itrussell15/SplitFlapDisplay/PCBs/driver-v3/board_schematic.png

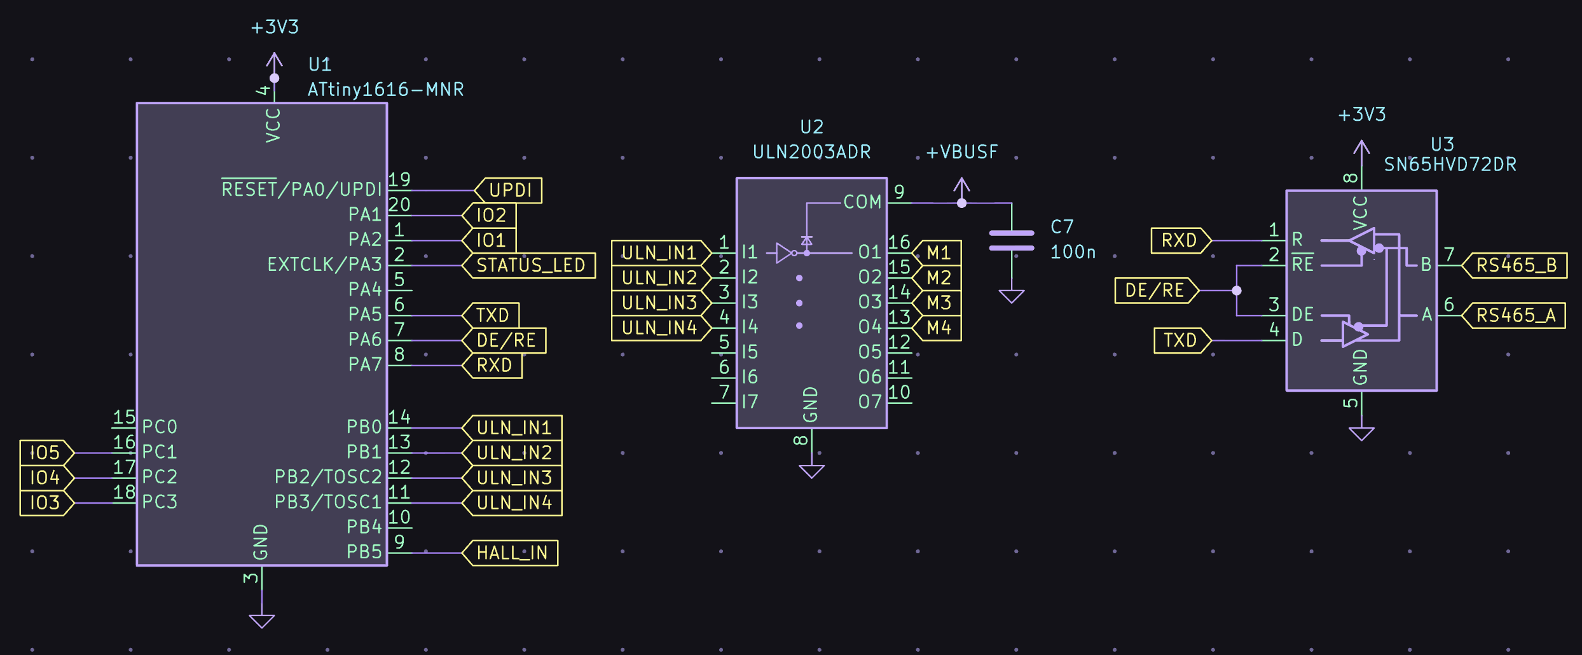
PCBs/driver-v3/board_schematic.png
