itrussell15/SplitFlapDisplay/PCBs/driver-v3/FAB/BOM File.xls

Comment | Designator | Footprint | JLCPCB Part #
ATtiny1616-MNR | U1 | VQFN-20-1EP_3x3mm_P0.4mm_EP1.7x1.7mm | C507118
470n | C3,C8,C6,C2 | C_0603_1608Metric | C1623
ULN2003ADR | U2 | SOIC-16W_5.3x10.2mm_P1.27mm | C7512
HallEffect | J4 | PinHeader_1x03_P2.54mm_Vertical | C131339
100u | C1 | C_Elec_5x5.4 | C3347
100n | C7 | C_0603_1608Metric | C14663
0R | R1 | R_0805_2012Metric | C17477
LED | D1 | LED_0201_0603Metric | C2286
StepperConnector | J3 | JST_XH_B5B-XH-A_1x05_P2.50mm_Vertical | C157991
SN65HVD72DR | U3 | SOIC-8_5.3x6.2mm_P1.27mm | C48125
60R | R2 | R_0201_0603Metric | C166918
SPX3819M5-L-3-3 | U5 | SOT-23-5 | C20617301
SPX3819M5-L-5-0 | U6 | SOT-23-5 | C20617302
10u | C5,C9,C4 | C_0603_1608Metric | C19702
