itrussell15/SplitFlapDisplay/CAD Files/Drum_Main.3mf

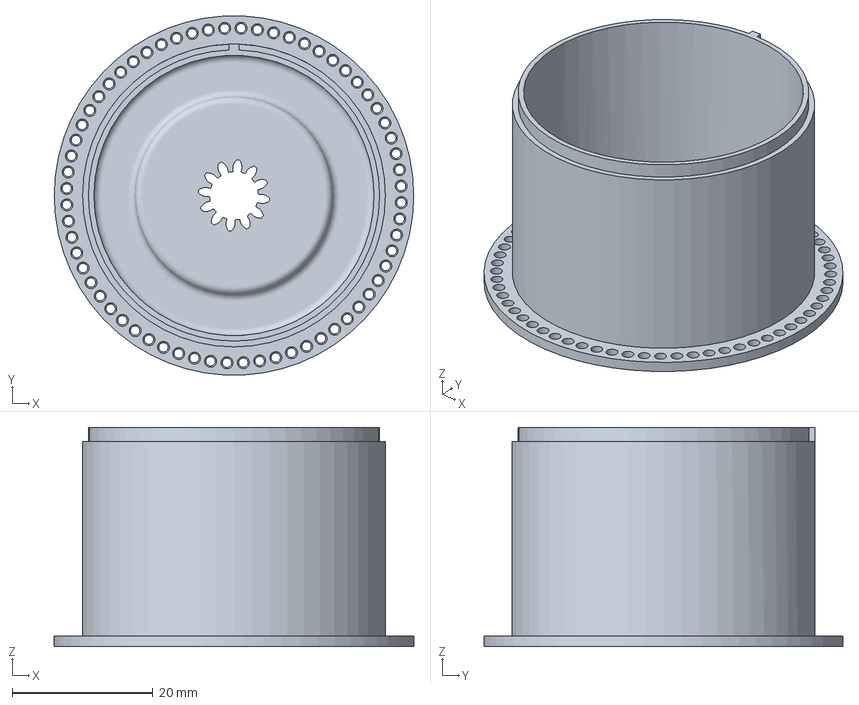
[picture p6: CAD file, 2026-07-28]
CAD Files/Drum_Main.3mf
51.0 x 50.9 x 31.1 mm
