itrussell15/SplitFlapDisplay/CAD Files/Character Drum - Character Drum Main.3mf

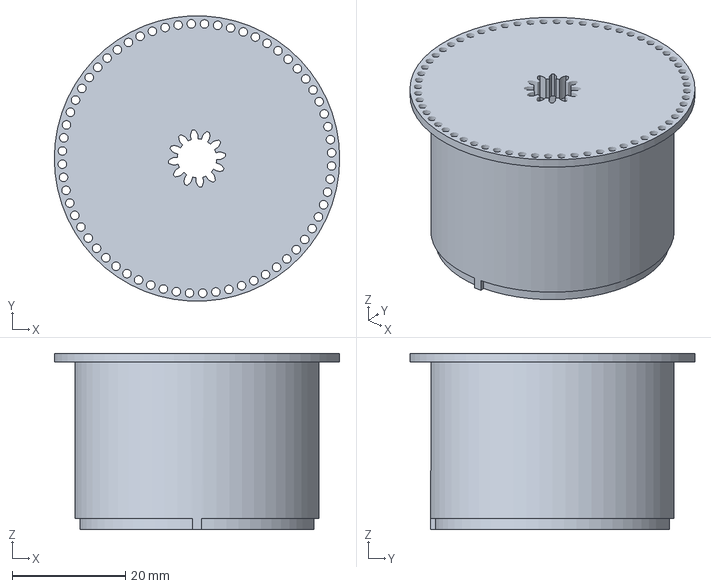
[picture p7: CAD file, 2026-05-07]
CAD Files/Character Drum - Character Drum Main.3mf
50.3 x 50.2 x 31.1 mm
