itrussell15/SplitFlapDisplay/CAD Files/64FlapsWithLetters (parts and bambu print profile)/Flap7.3mf

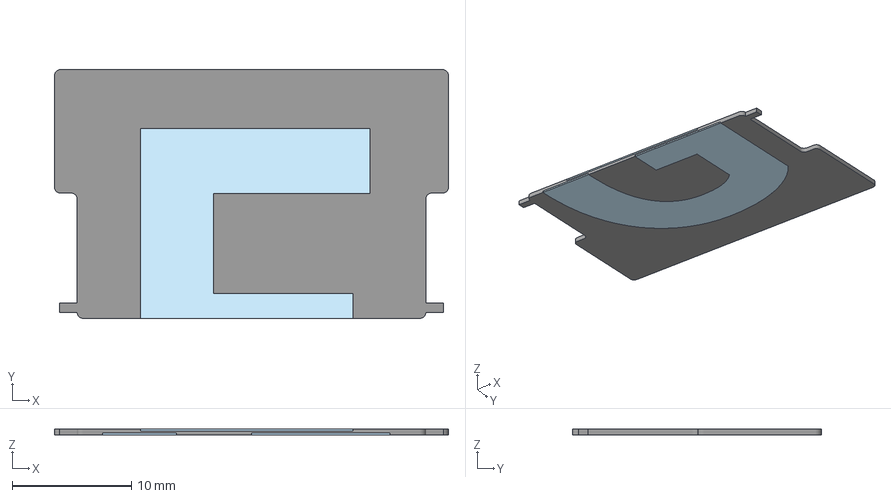
[picture p8: CAD file, 2026-05-07]
CAD Files/64FlapsWithLetters (parts and bambu print profile)/Flap7.3mf
33.1 x 20.9 x 0.48 mm
G_Bottom
Flap7
F_Top
