itrussell15/SplitFlapDisplay/CAD Files/flaps/mini_plate.3mf

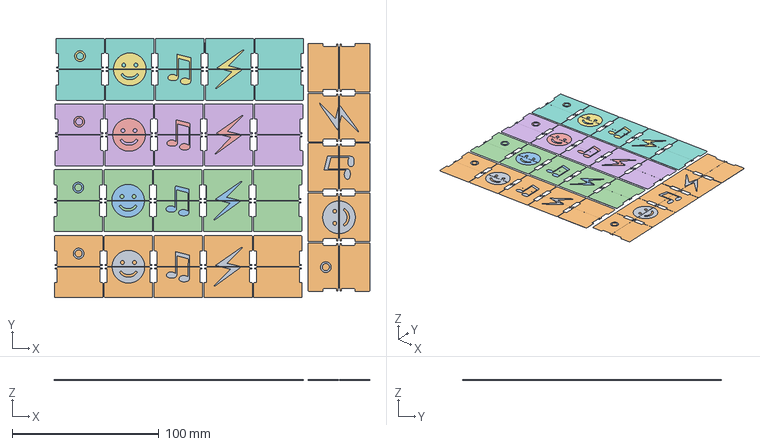
[picture p9: CAD file, 2026-08-07]
CAD Files/flaps/mini_plate.3mf
215.6 x 177.0 x 0.48 mm
mini_plate-inlay.stl x 5
mini_plate.stl x 5
