itrussell15/SplitFlapDisplay/CAD Files/flaps/single/3-E.3mf

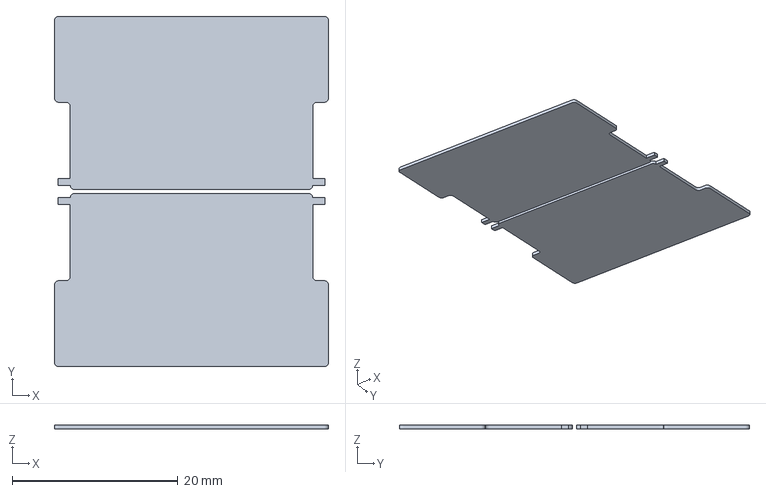
[picture p10: CAD file, 2026-09-01]
CAD Files/flaps/single/3-E.3mf
33.1 x 42.3 x 0.48 mm
