itrussell15/SplitFlapDisplay/flaps-generator/examples/1-flaps.stl

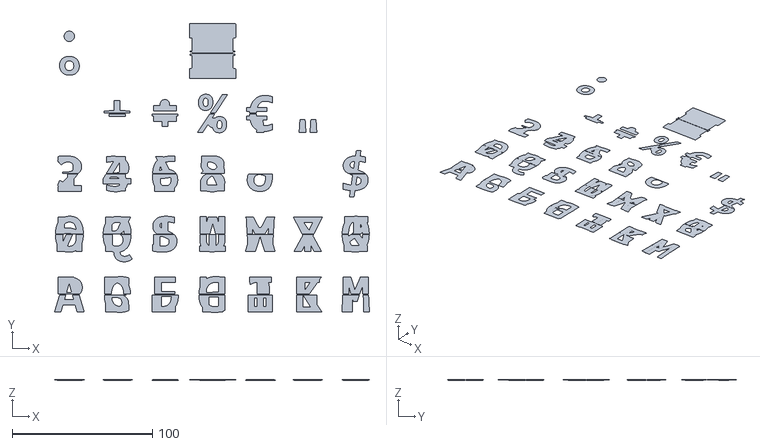
[picture p12: CAD file, 2026-05-22]
flaps-generator/examples/1-flaps.stl
224.4 x 206.0 x 0.48
