itrussell15/SplitFlapDisplay/flaps-generator/generated/Flaps_holding_case.stl

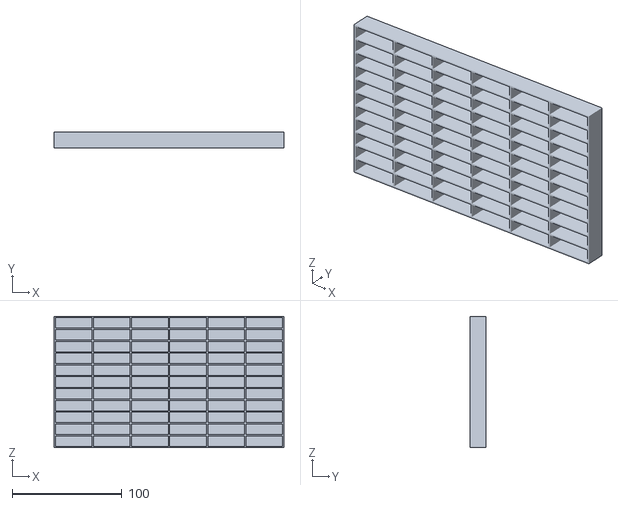
[picture p13: CAD file, 2026-06-04]
flaps-generator/generated/Flaps_holding_case.stl
210.0 x 15.0 x 120.0
