itrussell15/SplitFlapDisplay/flaps-generator/generated/plate1/plate1_inlay.stl

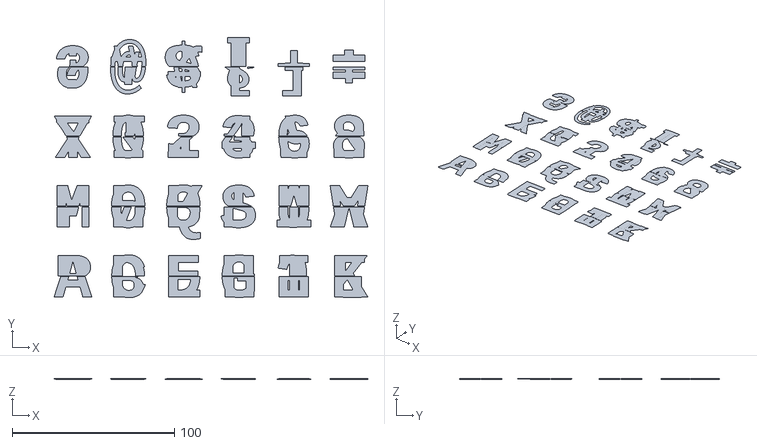
[picture p14: CAD file, 2026-06-03]
flaps-generator/generated/plate1/plate1_inlay.stl
193.3 x 160.3 x 0.48
