itrussell15/SplitFlapDisplay/flaps-generator/generated/plate2/plate2_inlay.stl

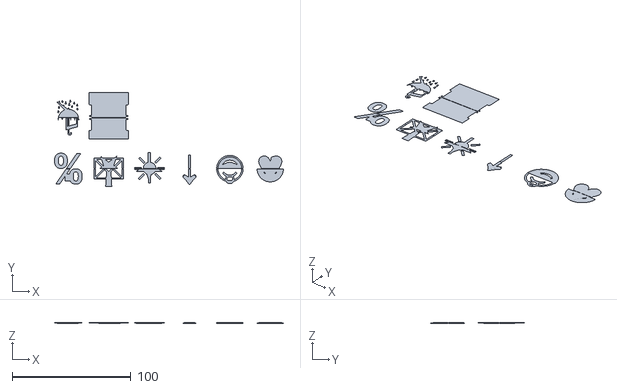
[picture p15: CAD file, 2026-06-03]
flaps-generator/generated/plate2/plate2_inlay.stl
192.8 x 79.2 x 0.48
