itrussell15/SplitFlapDisplay/flaps-generator/generated/plate3/plate3_inlay.stl

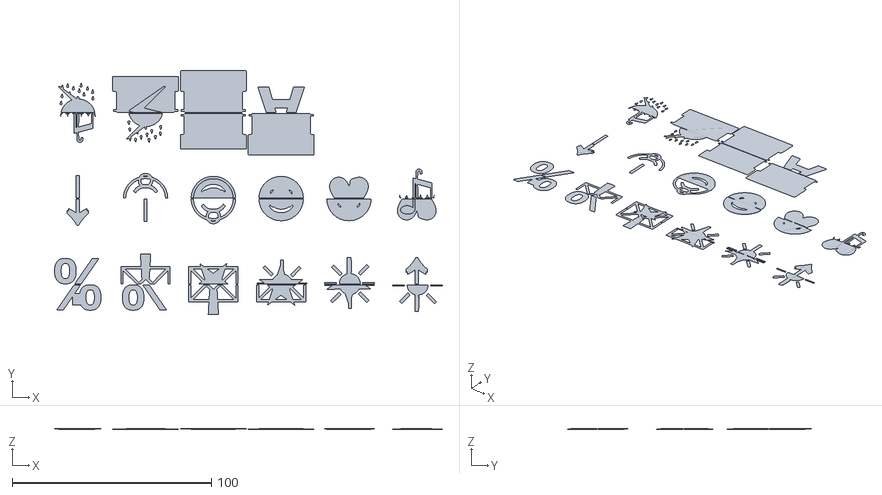
[picture p16: CAD file, 2026-06-02]
flaps-generator/generated/plate3/plate3_inlay.stl
194.6 x 122.2 x 0.48
