itrussell15/SplitFlapDisplay/PCBs/bus-board/SplitFlapBusBoard.step

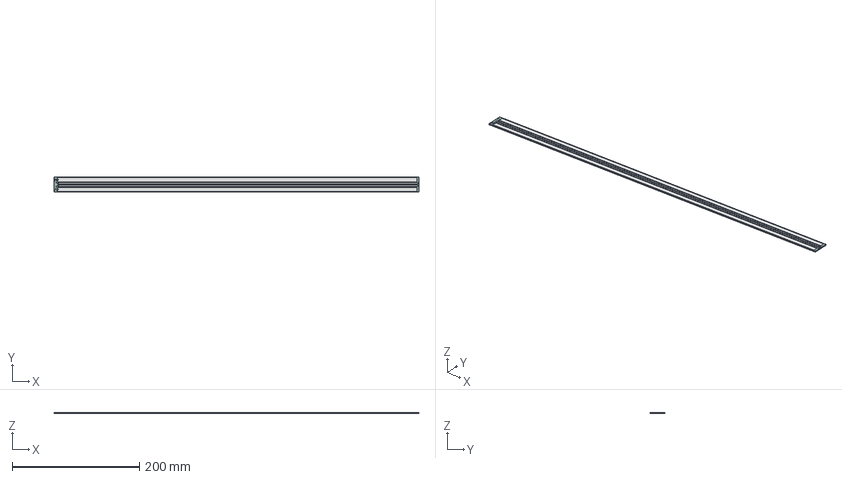
[picture p17: CAD file, 2026-05-07]
PCBs/bus-board/SplitFlapBusBoard.step
572.6 x 24.0 x 1.62 mm
SplitFlapBusBoard_pad
SplitFlapBusBoard_silkscreen
SplitFlapBusBoard_PCB
