itrussell15/SplitFlapDisplay/CAD Files/64FlapsWithLetters (parts and bambu print profile)/Flap31.3mf

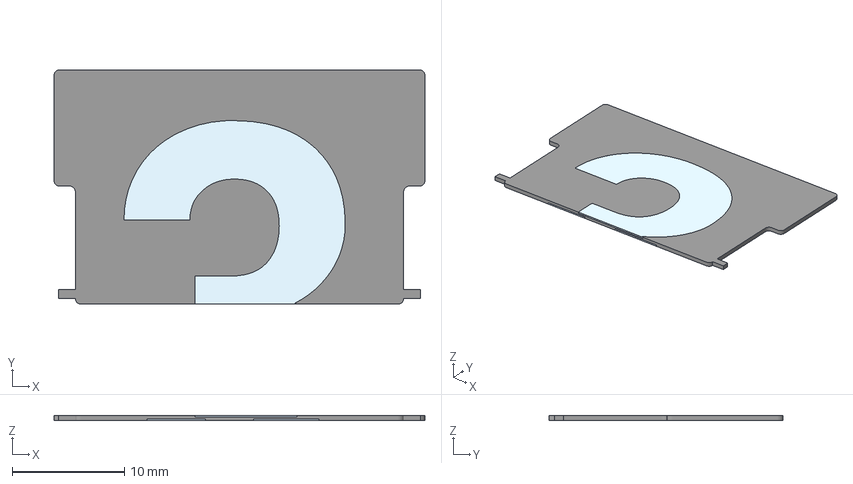
[picture p18: CAD file, 2026-05-07]
CAD Files/64FlapsWithLetters (parts and bambu print profile)/Flap31.3mf
33.1 x 20.9 x 0.48 mm
4_Bottom
Flap31
3_Top
