itrussell15/SplitFlapDisplay/CAD Files/Drum_Lip.3mf

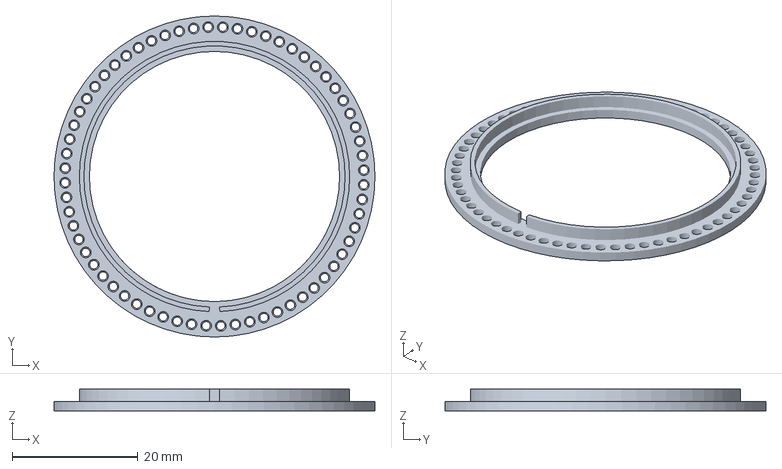
[picture p19: CAD file, 2026-07-28]
CAD Files/Drum_Lip.3mf
51.0 x 51.0 x 3.45 mm
