itrussell15/SplitFlapDisplay/CAD Files/flaps/mega_plate.3mf

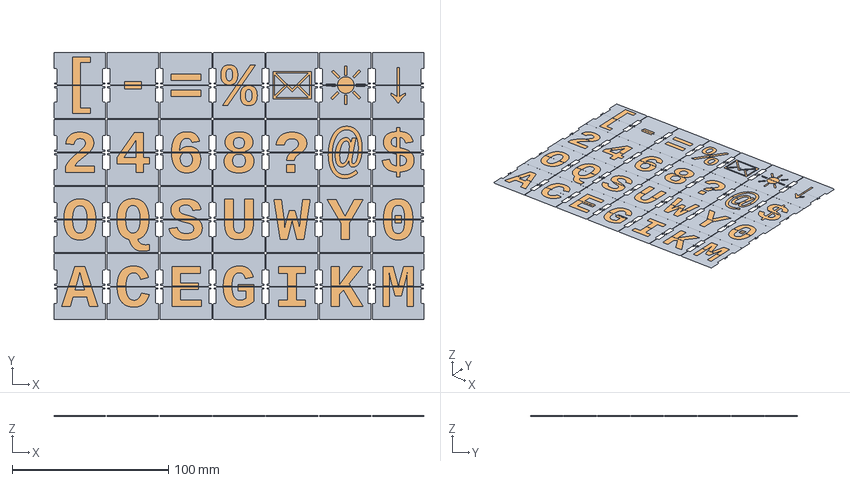
[picture p20: CAD file, 2026-08-07]
CAD Files/flaps/mega_plate.3mf
237.1 x 171.3 x 0.48 mm
mega_plate2.stl
mega_plate2-inlay.stl
