itrussell15/SplitFlapDisplay/CAD Files/flaps/single/2-C.3mf

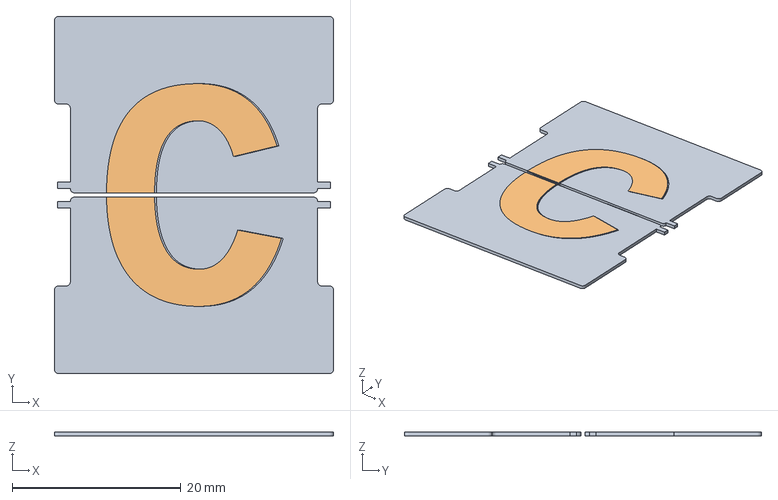
[picture p21: CAD file, 2026-09-01]
CAD Files/flaps/single/2-C.3mf
33.1 x 42.3 x 0.48 mm
2-C.stl
2-C-inlay.stl
