itrussell15/SplitFlapDisplay/CAD Files/flaps/small_plate2.3mf

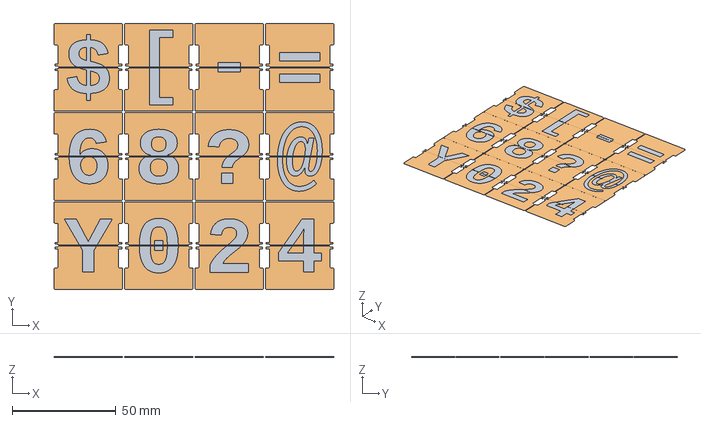
[picture p23: CAD file, 2026-07-28]
CAD Files/flaps/small_plate2.3mf
135.1 x 128.3 x 0.48 mm
small_plate2_inlay.stl
small_plate2.stl
