itrussell15/SplitFlapDisplay/CAD Files/top_cover.3mf

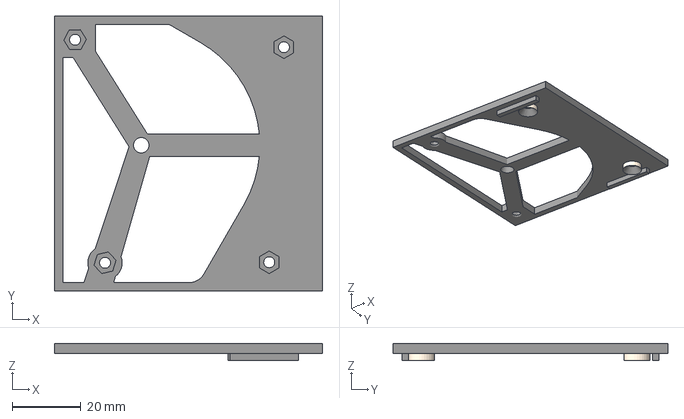
[picture p24: CAD file, 2026-07-22]
CAD Files/top_cover.3mf
78.0 x 80.0 x 5.00 mm
