itrussell15/SplitFlapDisplay/flaps-generator/examples/4-flaps.stl

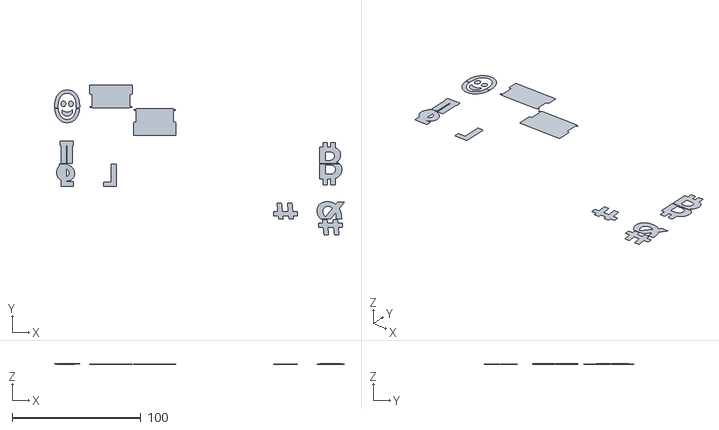
[picture p25: CAD file, 2026-05-22]
flaps-generator/examples/4-flaps.stl
225.1 x 116.6 x 0.48
