itrussell15/SplitFlapDisplay/flaps-generator/flap.dxf

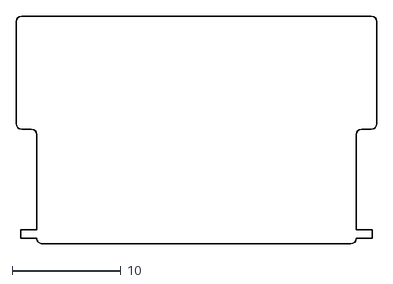
[picture p26: CAD file, 2026-05-07]
flaps-generator/flap.dxf
33.1 x 20.9
