itrussell15/SplitFlapDisplay/CAD Files/flaps/small_plate3.3mf

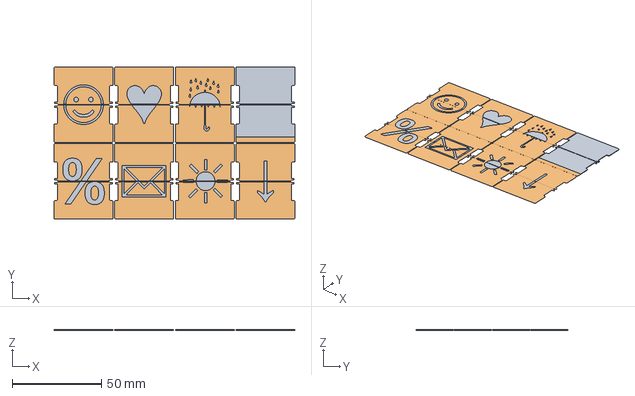
[picture p29: CAD file, 2026-07-18]
CAD Files/flaps/small_plate3.3mf
135.2 x 85.4 x 0.48 mm
small_plate3_inlay.stl
small_plate3.stl
