itrussell15/SplitFlapDisplay/flaps-generator/examples/0-flaps.stl

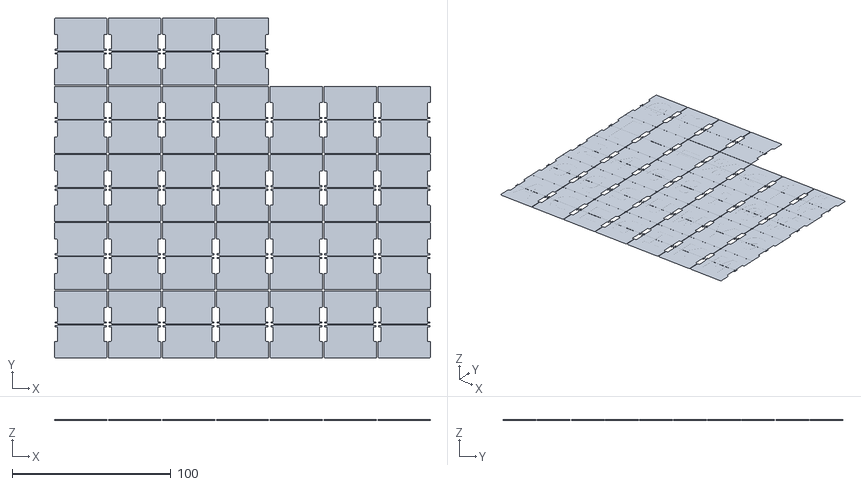
[picture p30: CAD file, 2026-05-22]
flaps-generator/examples/0-flaps.stl
237.1 x 214.3 x 0.48
