itrussell15/SplitFlapDisplay/CAD Files/flaps/small_plate1.3mf

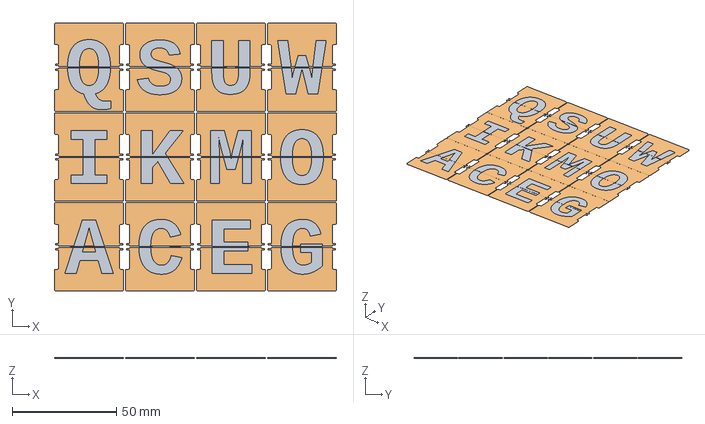
[picture p32: CAD file, 2026-07-18]
CAD Files/flaps/small_plate1.3mf
135.1 x 128.3 x 0.48 mm
small_plate1_inlay.stl
small_plate1.stl
