itrussell15/SplitFlapDisplay/CAD Files/Gear_Plate.3mf

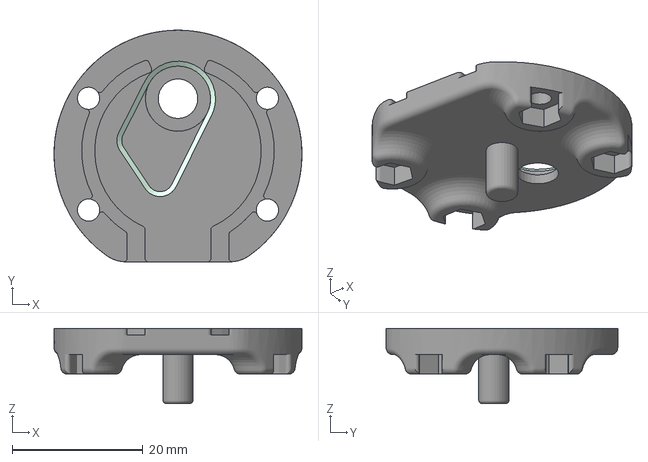
[picture p33: CAD file, 2026-07-15]
CAD Files/Gear_Plate.3mf
38.0 x 35.5 x 11.5 mm
