itrussell15/SplitFlapDisplay/flaps-generator/examples/3-flaps.stl

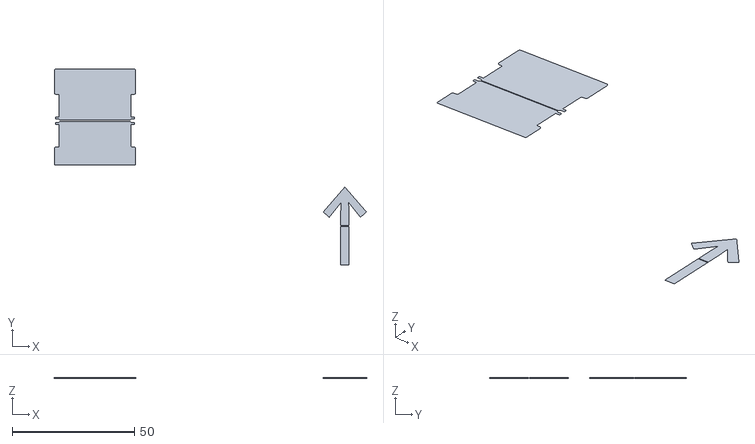
[picture p34: CAD file, 2026-05-22]
flaps-generator/examples/3-flaps.stl
127.4 x 80.1 x 0.16
