itrussell15/SplitFlapDisplay/CAD Files/flaps/plate1.3mf

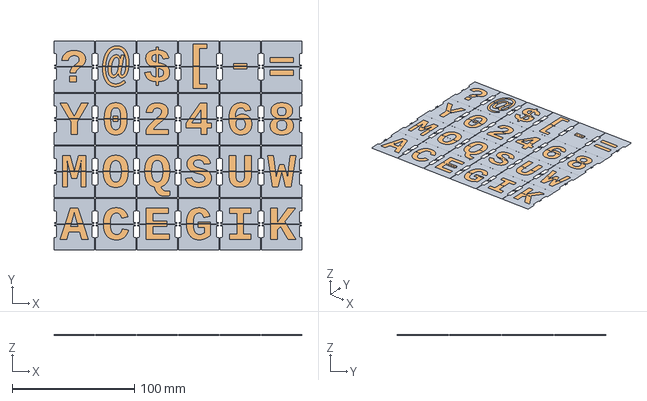
[picture p35: CAD file, 2026-07-03]
CAD Files/flaps/plate1.3mf
203.1 x 171.3 x 0.48 mm
plate1.stl
plate1_inlay.stl
