itrussell15/SplitFlapDisplay/CAD Files/module_case.3mf

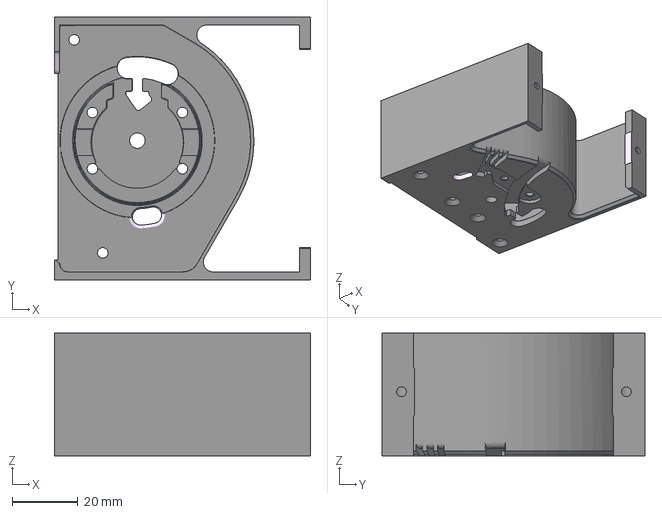
[picture p37: CAD file, 2026-07-10]
CAD Files/module_case.3mf
78.0 x 80.0 x 37.4 mm
