itrussell15/SplitFlapDisplay/CAD Files/Din Bracket EasierV2.stl

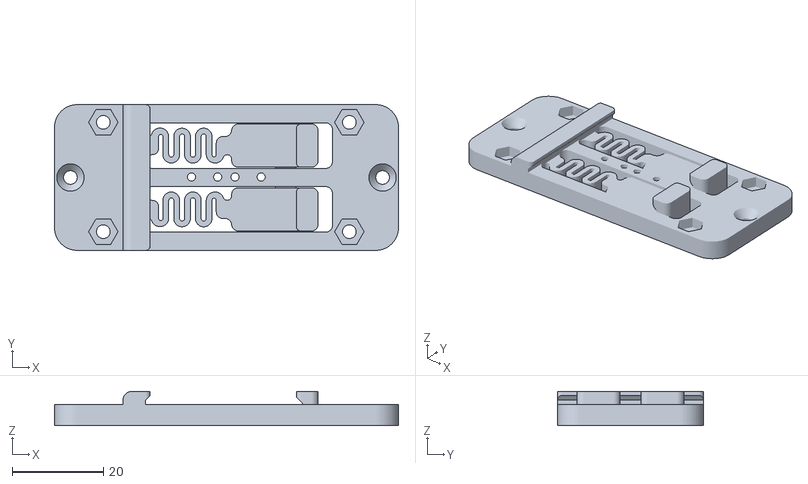
[picture p38: CAD file, 2026-05-11]
CAD Files/Din Bracket EasierV2.stl
75.5 x 32.0 x 7.50
