itrussell15/SplitFlapDisplay/CAD Files/flaps/plate2.3mf

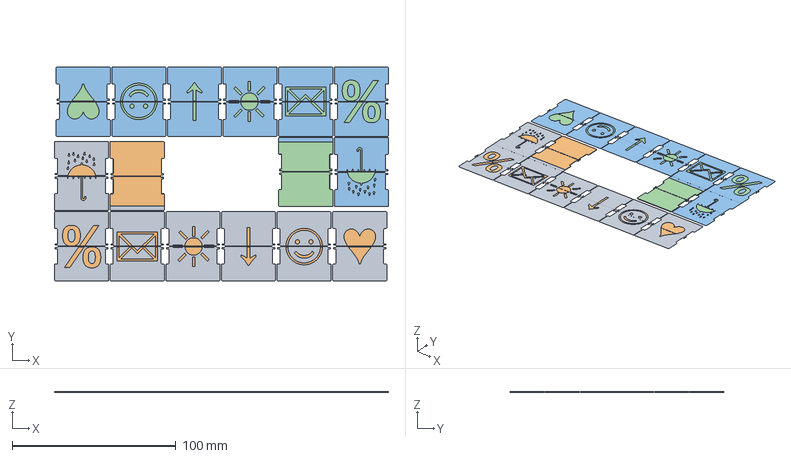
[picture p39: CAD file, 2026-06-04]
CAD Files/flaps/plate2.3mf
204.1 x 130.7 x 0.48 mm
plate2.stl x 2
plate2_inlay.stl x 2
