itrussell15/SplitFlapDisplay/flaps-generator/examples/2-flaps.stl

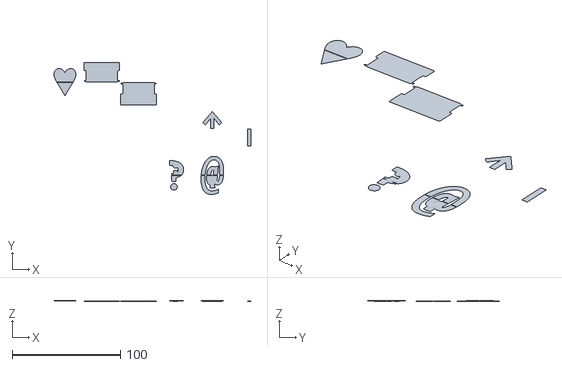
[picture p41: CAD file, 2026-05-22]
flaps-generator/examples/2-flaps.stl
181.8 x 121.8 x 0.48
