itrussell15/SplitFlapDisplay/CAD Files/Module Enclosure - Enclosure Cover Bottom.3mf

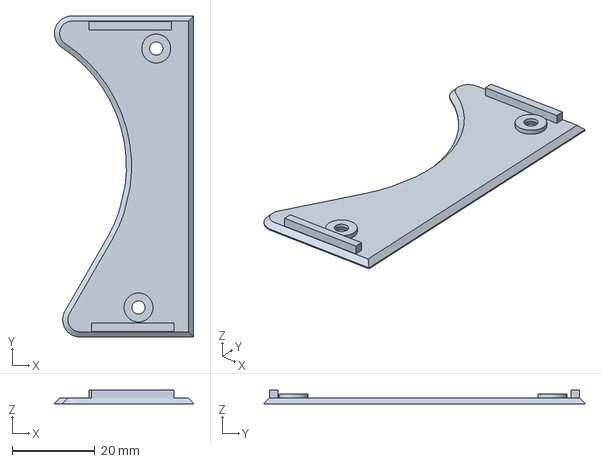
[picture p42: CAD file, 2026-05-07]
CAD Files/Module Enclosure - Enclosure Cover Bottom.3mf
33.6 x 77.6 x 3.50 mm
