itrussell15/SplitFlapDisplay/CAD Files/Wire Retainer.3mf

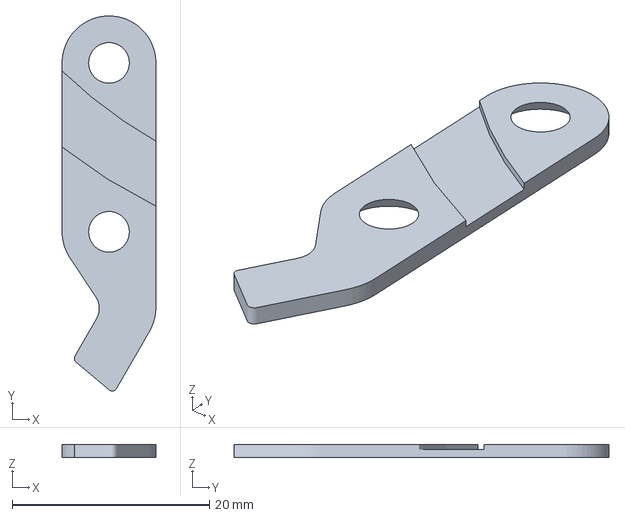
[picture p45: CAD file, 2026-05-07]
CAD Files/Wire Retainer.3mf
9.52 x 38.0 x 1.30 mm
