itrussell15/SplitFlapDisplay/CAD Files/Motor Gear.3mf

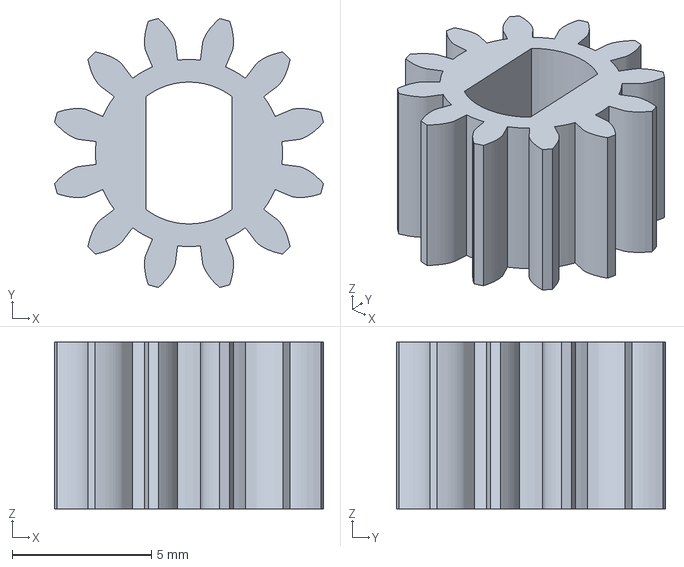
[picture p46: CAD file, 2026-05-07]
CAD Files/Motor Gear.3mf
9.67 x 9.67 x 6.00 mm
