itrussell15/SplitFlapDisplay/CAD Files/64FlapsWithLetters (parts and bambu print profile)/64FlapsPrintProfile.3mf

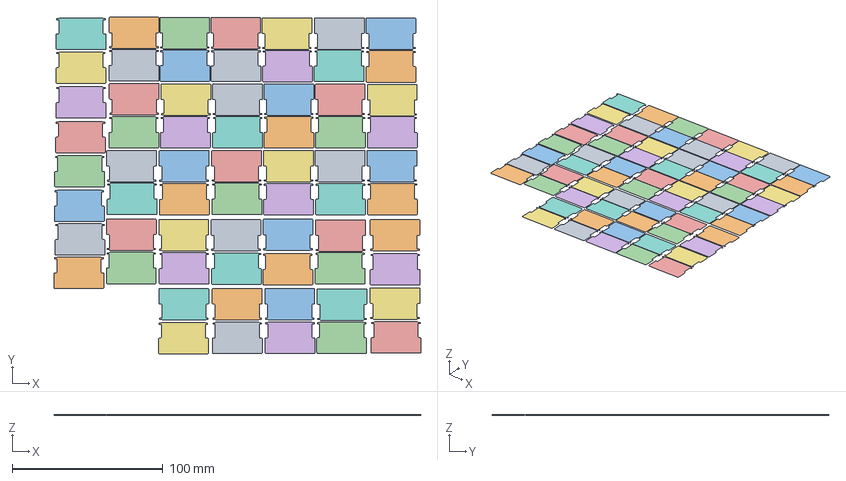
[picture p47: CAD file, 2026-05-07]
CAD Files/64FlapsWithLetters (parts and bambu print profile)/64FlapsPrintProfile.3mf
243.4 x 223.3 x 0.48 mm
Flap10
Flap2
Flap3
Flap4
Flap6
Flap7
Flap8
Flap9
Flap1
Flap11
Flap12
Flap13
Flap14
Flap15
Flap16
Flap17
Flap18
Flap19
Flap20
Flap21
Flap22
Flap23
Flap24
Flap25
Flap26
Flap27
Flap28
Flap29
Flap30
Flap31
Flap32
Flap33
Flap34
Flap35
Flap36
Flap37
Flap38
Flap39
Flap40
Flap41
Flap42
Flap43
Flap44
Flap45
Flap46
Flap47
Flap49
Flap50
Flap51
Flap52
Flap54
Flap55
Flap57 x 9
Flap53
Flap58
Assembly
Flap5
Flap48
