itrussell15/SplitFlapDisplay/CAD Files/Center Gear.3mf

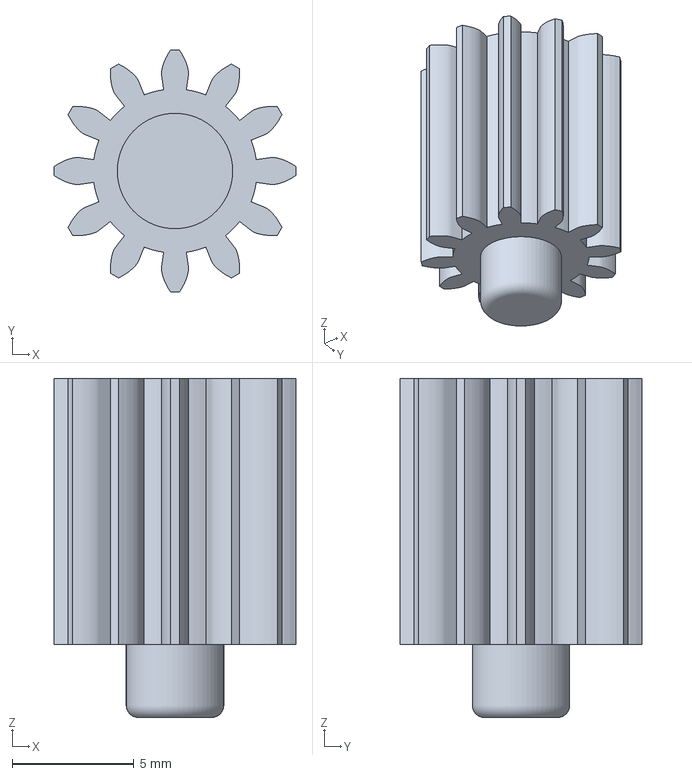
[picture p48: CAD file, 2026-05-07]
CAD Files/Center Gear.3mf
9.91 x 9.91 x 13.9 mm
