itrussell15/SplitFlapDisplay/CAD Files/flaps/single/32-WHITE.3mf

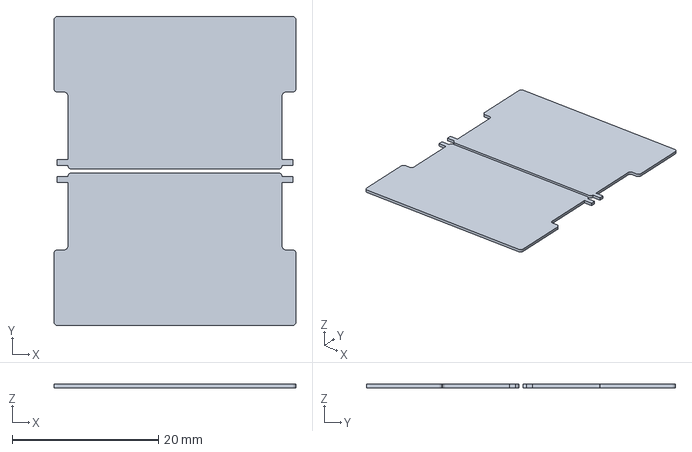
[picture p49: CAD file, 2026-08-17]
CAD Files/flaps/single/32-WHITE.3mf
33.1 x 42.3 x 0.48 mm
