itrussell15/SplitFlapDisplay/CAD Files/64FlapsWithLetters (parts and bambu print profile)/Flap57 - Blank (print 7).3mf

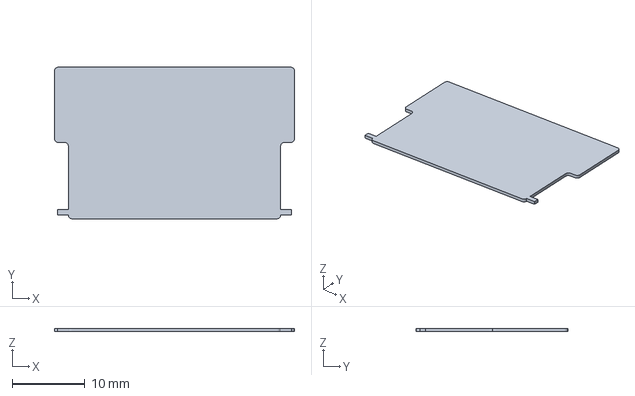
[picture p50: CAD file, 2026-05-07]
CAD Files/64FlapsWithLetters (parts and bambu print profile)/Flap57 - Blank (print 7).3mf
33.1 x 20.9 x 0.48 mm
