itrussell15/SplitFlapDisplay/CAD Files/64FlapsWithLetters (parts and bambu print profile)/Flap56.3mf

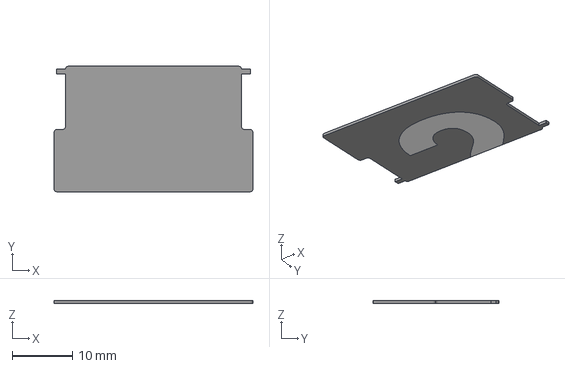
[picture p51: CAD file, 2026-05-07]
CAD Files/64FlapsWithLetters (parts and bambu print profile)/Flap56.3mf
33.1 x 20.9 x 0.48 mm
Question_Top
Flap56
