itrussell15/SplitFlapDisplay/CAD Files/Character Drum - Character Drum Lip.3mf

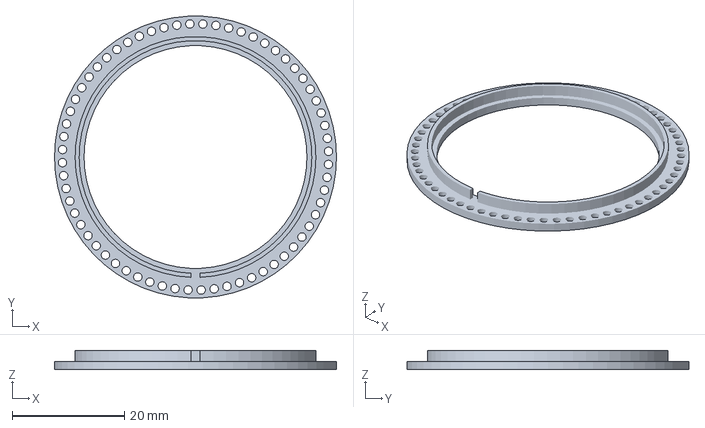
[picture p53: CAD file, 2026-05-07]
CAD Files/Character Drum - Character Drum Lip.3mf
50.3 x 50.2 x 3.45 mm
