itrussell15/SplitFlapDisplay/CAD Files/Character Drum.3mf

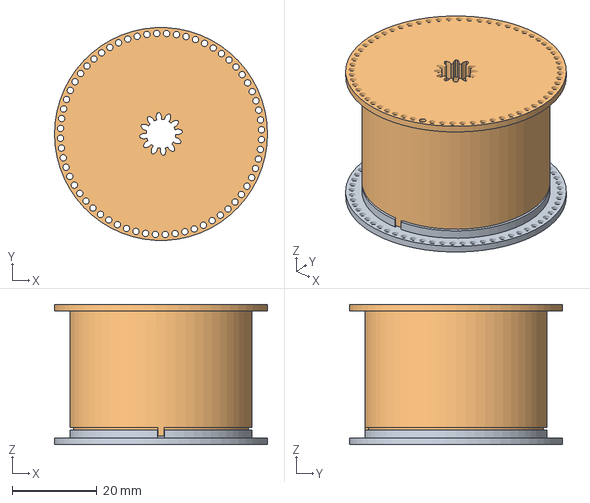
[picture p55: CAD file, 2026-05-07]
CAD Files/Character Drum.3mf
50.3 x 50.2 x 33.1 mm
Character Drum Lip
Character Drum Main
