itrussell15/SplitFlapDisplay/CAD Files/Module Enclosure - Enclosure Cover Top.3mf

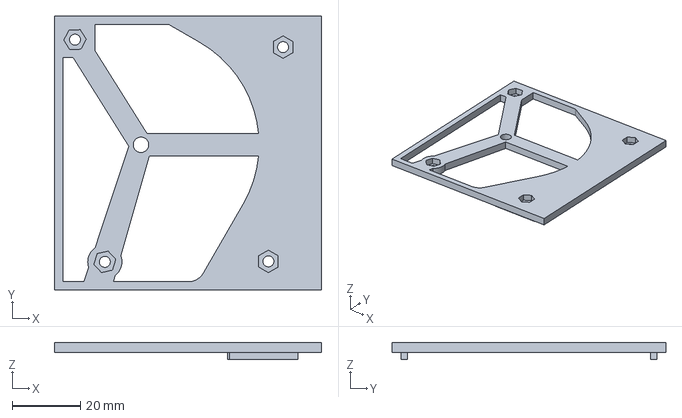
[picture p56: CAD file, 2026-05-07]
CAD Files/Module Enclosure - Enclosure Cover Top.3mf
78.0 x 80.0 x 5.00 mm
