itrussell15/SplitFlapDisplay/CAD Files/64FlapsWithLetters (parts and bambu print profile)/Flap39.3mf

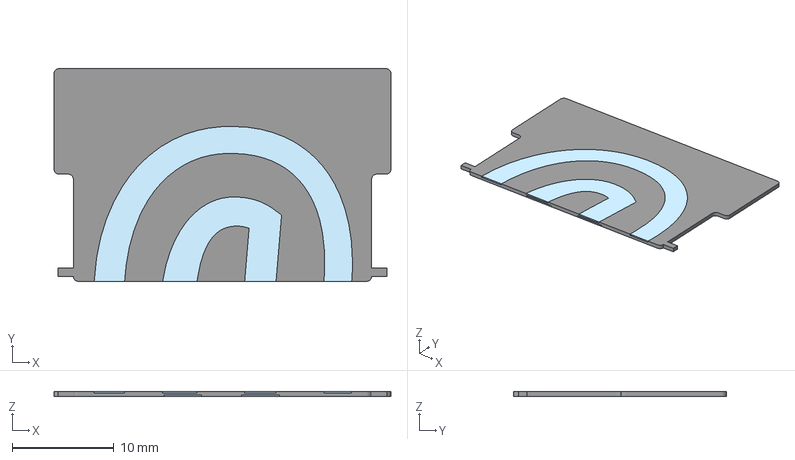
[picture p58: CAD file, 2026-05-07]
CAD Files/64FlapsWithLetters (parts and bambu print profile)/Flap39.3mf
33.1 x 20.9 x 0.48 mm
AT_Top x 2
Pound_Bottom
Flap39
