itrussell15/SplitFlapDisplay/CAD Files/flaps/single/28-DOWN.3mf

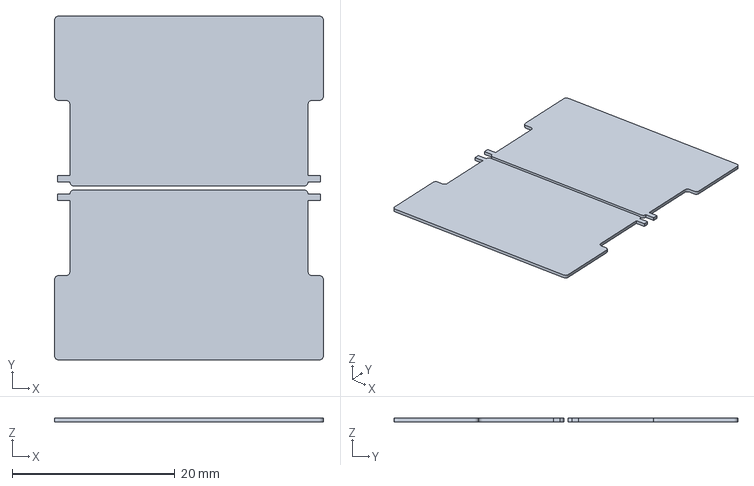
[picture p61: CAD file, 2026-08-17]
CAD Files/flaps/single/28-DOWN.3mf
33.1 x 42.3 x 0.48 mm
