itrussell15/SplitFlapDisplay/CAD Files/64FlapsWithLetters (parts and bambu print profile)/Flap46.3mf

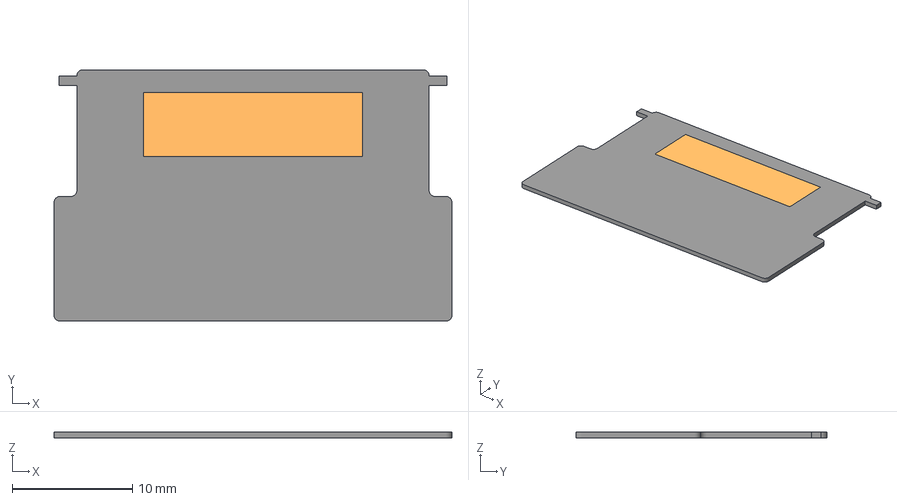
[picture p62: CAD file, 2026-05-07]
CAD Files/64FlapsWithLetters (parts and bambu print profile)/Flap46.3mf
33.1 x 20.9 x 0.48 mm
Flap46
Equal_Bottom
