itrussell15/SplitFlapDisplay/CAD Files/64FlapsWithLetters (parts and bambu print profile)/Flap15.3mf

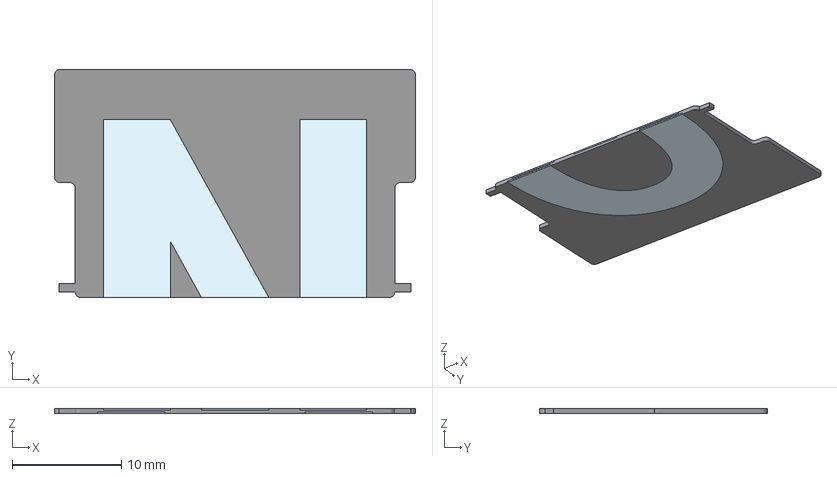
[picture p63: CAD file, 2026-05-07]
CAD Files/64FlapsWithLetters (parts and bambu print profile)/Flap15.3mf
33.1 x 20.9 x 0.48 mm
N_Top x 2
O_Bottom
Flap15
