itrussell15/SplitFlapDisplay/(list of files, cad)

Other CAD files:
flaps-generator/Flaps_holding_case.stl
CAD Files/64FlapsWithLetters (parts and bambu print profile)/Flap12.3mf
CAD Files/64FlapsWithLetters (parts and bambu print profile)/Flap2.3mf
CAD Files/64FlapsWithLetters (parts and bambu print profile)/Flap17.3mf
flaps-generator/examples/Flaps_holding_case.stl
CAD Files/64FlapsWithLetters (parts and bambu print profile)/Flap26.3mf
CAD Files/64FlapsWithLetters (parts and bambu print profile)/Flap19.3mf
CAD Files/flaps/single/12-W.3mf
CAD Files/flaps/single/22-LEFT-PAREN.3mf
CAD Files/Module Enclosure - Enclosure.3mf
CAD Files/flaps/single/30-HEART.3mf
CAD Files/64FlapsWithLetters (parts and bambu print profile)/Flap21.3mf
CAD Files/flaps/single/20-AT.3mf
CAD Files/flaps/single/17-SIX.3mf
CAD Files/DIN Rail Mount.3mf
CAD Files/64FlapsWithLetters (parts and bambu print profile)/Flap28.3mf
CAD Files/flaps/single/15-TWO.3mf
CAD Files/flaps/single/7-M.3mf
CAD Files/64FlapsWithLetters (parts and bambu print profile)/Flap29.3mf
CAD Files/flaps/single/11-U.3mf
CAD Files/flaps/single/29-SMILEY.3mf
CAD Files/flaps/single/25-PERCENT.3mf
CAD Files/64FlapsWithLetters (parts and bambu print profile)/Flap8.3mf
CAD Files/flaps/single/8-O.3mf
CAD Files/64FlapsWithLetters (parts and bambu print profile)/Flap4.3mf
CAD Files/flaps/single/1-A.3mf
CAD Files/flaps/single/14-ZERO.3mf
CAD Files/64FlapsWithLetters (parts and bambu print profile)/Flap23.3mf
CAD Files/flaps/single/24-EQUALS.3mf
CAD Files/64FlapsWithLetters (parts and bambu print profile)/Flap33.3mf
CAD Files/64FlapsWithLetters (parts and bambu print profile)/Flap52.3mf
CAD Files/flaps/single/4-G.3mf
CAD Files/64FlapsWithLetters (parts and bambu print profile)/Flap22.3mf
CAD Files/flaps/single/23-DASH.3mf
CAD Files/64FlapsWithLetters (parts and bambu print profile)/Flap13.3mf
CAD Files/flaps/single/6-K.3mf
CAD Files/64FlapsWithLetters (parts and bambu print profile)/Flap44.3mf
CAD Files/flaps/single/21-DOLLAR.3mf
CAD Files/64FlapsWithLetters (parts and bambu print profile)/Flap47.3mf
CAD Files/flaps/single/10-S.3mf
CAD Files/64FlapsWithLetters (parts and bambu print profile)/Flap24.3mf
CAD Files/flaps/single/5-I.3mf
CAD Files/64FlapsWithLetters (parts and bambu print profile)/Flap36.3mf
CAD Files/flaps/single/18-EIGHT.3mf
CAD Files/64FlapsWithLetters (parts and bambu print profile)/Flap3.3mf
CAD Files/64FlapsWithLetters (parts and bambu print profile)/Flap5.3mf
CAD Files/64FlapsWithLetters (parts and bambu print profile)/Flap18.3mf
CAD Files/64FlapsWithLetters (parts and bambu print profile)/Flap50.3mf
CAD Files/64FlapsWithLetters (parts and bambu print profile)/Flap10.3mf
CAD Files/64FlapsWithLetters (parts and bambu print profile)/Flap53.3mf
CAD Files/64FlapsWithLetters (parts and bambu print profile)/Flap30.3mf
CAD Files/64FlapsWithLetters (parts and bambu print profile)/Flap35.3mf
CAD Files/64FlapsWithLetters (parts and bambu print profile)/Flap9.3mf
CAD Files/64FlapsWithLetters (parts and bambu print profile)/Flap41.3mf
CAD Files/64FlapsWithLetters (parts and bambu print profile)/Flap43.3mf
CAD Files/64FlapsWithLetters (parts and bambu print profile)/Flap25.3mf
CAD Files/64FlapsWithLetters (parts and bambu print profile)/Flap42.3mf
CAD Files/64FlapsWithLetters (parts and bambu print profile)/Flap38.3mf
CAD Files/64FlapsWithLetters (parts and bambu print profile)/Flap45.3mf
CAD Files/64FlapsWithLetters (parts and bambu print profile)/Flap27.3mf
CAD Files/64FlapsWithLetters (parts and bambu print profile)/Flap20.3mf
CAD Files/64FlapsWithLetters (parts and bambu print profile)/Flap32.3mf
CAD Files/64FlapsWithLetters (parts and bambu print profile)/Flap49.3mf
CAD Files/64FlapsWithLetters (parts and bambu print profile)/Flap11.3mf
CAD Files/64FlapsWithLetters (parts and bambu print profile)/Flap55.3mf
CAD Files/64FlapsWithLetters (parts and bambu print profile)/Flap6.3mf
CAD Files/64FlapsWithLetters (parts and bambu print profile)/Flap48.3mf
CAD Files/64FlapsWithLetters (parts and bambu print profile)/Flap37.3mf
CAD Files/64FlapsWithLetters (parts and bambu print profile)/Flap16.3mf
CAD Files/64FlapsWithLetters (parts and bambu print profile)/Flap58.3mf
flaps-generator/flaps_4plate.scad
CAD Files/DIN Spacer with Screw Hole.stl
CAD Files/Gear Plate.3mf
CAD Files/archive/DIN Rail Mount.3mf
CAD Files/archive/Gear Plate.3mf
CAD Files/archive/Module Enclosure - Enclosure.3mf
CAD Files/din_rail_mount.stl
