itrussell15/SplitFlapDisplay/software/control/calibration/test_words.txt

APPLE
BEACH
BRAIN
BREAD
BRUSH
CHAIR
CHESS
CLOUD
CRANE
DANCE
DREAM
EARTH
EAGER
FEAST
FIELD
FLAME
FLUTE
FRUIT
GLASS
GRAPE
HEART
HOUSE
JUICE
LIGHT
LEMON
MOUSE
MUSIC
NIGHT
OCEAN
PAINT
PAPER
PIANO
PILOT
PLANE
PLANT
PLATE
QUICK
RADIO
RIVER
ROBOT
SCALE
SHIRT
SMILE
SPACE
SPOON
TABLE
TIGER
TRAIN
WATER
WORLD
