itrussell15/SplitFlapDisplay/software/control/source/module_controller.py

import enum
import logging
import struct
import time
from dataclasses import dataclass
from concurrent.futures import Future
from queue import Queue
from typing import Any, Dict, Optional, Tuple

from .dataclasses_ import (
    IncomingMessage,
    ModuleCommand,
    ModuleErrorCodes,
    OutgoingMessage,
    LatencyMs
)

import utils

MIN_ROW_VALUE = 0
MAX_ROW_VALUE = 255
MIN_COLUMN_VALUE = 0
MAX_COLUMN_VALUE = 255
NUM_EEPROM_BYTES = 256

MOTOR_RESOLUTION = int(utils.get_env_var("DISP_MOTOR_RESOLUTION", "4096"))
NUM_POSITIONS = int(utils.get_env_var("DISP_NUM_FLAPS", "64"))


class FirmwareException(Exception):
    pass


class EepromLocations(enum.IntEnum):
    MODULE_ROW_LOCATION = 0
    MODULE_COLUMN_LOCATION = 1
    MAJOR_FIRMWARE_LOCATION = 2
    MINOR_FIRMWARE_LOCATION = 3
    AUTO_HOME_LOCATION = 4
    HOME_OFFSET_VALUE_LOCATION = 5
    MAX_STEP_LOCATION = 7
    POSITION_VALUES_START_LOCATION = 100


@dataclass
class ModuleInfo:
    row: int
    column: int
    bus: str
    major_firmware_version: int
    minor_firmware_version: int
    steps: int
    auto_home: bool
    home_offset: int
    max_steps: int
    

    @property
    def location(self) -> Tuple[int, int]:
        return (self.row, self.column)


class ModuleController:
    """
    Generates commands and tracks the state of a given module.
    """

    def __init__(self, row: int, column: int, log_level: int = logging.INFO) -> None:
        self.logger = logging.getLogger(f"{self.__class__.__name__}({row}, {column})")
        self.logger.setLevel(log_level)
        
        self.logger.debug(f"Module at ({row}, {column}) created")

        if row < MIN_ROW_VALUE or row > MAX_ROW_VALUE:
            raise ValueError(
                f"Row {row} not allowed. Must be {MIN_ROW_VALUE} <= x <= {MAX_ROW_VALUE}"
            )
        if column < MIN_COLUMN_VALUE or column > MAX_COLUMN_VALUE:
            raise ValueError(
                f"Column {column} not allowed. Must be {MIN_COLUMN_VALUE} <= x <= {MAX_COLUMN_VALUE}"
            )

        self._location = (row, column)
        self._command_queue = None
        self._is_homed: bool = False
        self._current_step: int = 0
        self._current_position: int = 0
        self._message_count: int = 0
        self._lifetime_latency = LatencyMs(0, 0, 0)
        self._bus: Optional[str] = None
        self._info = None

        # Have to initialize before calling `get_all_positions` otherwise no positions to request for
        self._positions_to_steps = {i: None for i in range(NUM_POSITIONS)}

    def register_command_queue(self, queue: Queue, queue_id: str) -> None:
        if not isinstance(queue, Queue):
            raise TypeError(f"Type: {type(queue)} is not allowed")
        self.logger.info(f"Command queue registered")
        self._command_queue = queue
        self._bus = queue_id

    def unregister_command_queue(self) -> Queue:
        if self._command_queue is None:
            self.logger.warning("No command queue registered to unregister")
            return
        queue = self._command_queue
        self._command_queue = None
        self.logger.info(f"Command queue unregistered")
        return queue

    def get_module_info(self) -> ModuleInfo:
        self.logger.info(f"Requesting module information for {self._location}")
        auto_home = self.get_eeprom_value(EepromLocations.AUTO_HOME_LOCATION)
        home_offset = self.get_home_offset()
        max_steps = self.get_max_steps()

        # Update self._current_step
        self.get_steps()
        
        major_firmware = self.get_eeprom_value(EepromLocations.MAJOR_FIRMWARE_LOCATION)
        minor_firmware = self.get_eeprom_value(EepromLocations.MINOR_FIRMWARE_LOCATION)
        
        info = ModuleInfo(
            row=self.row,
            column=self.column,
            bus=self._bus,
            major_firmware_version=int(major_firmware),
            minor_firmware_version=int(minor_firmware),
            steps=self._current_step,
            max_steps=max_steps,
            auto_home=bool(auto_home),
            home_offset=int(home_offset)
        )
        self._info = info
        return self._info
        
    def move_to_step(self, step: int) -> IncomingMessage:
        self.logger.info(f"Moving to {step}")
        if not self.is_valid_step(step):
            raise ValueError(f"Step value: {step} must be between 0-{MOTOR_RESOLUTION}")
        result = self._send_packet(ModuleCommand.MOVE_TO_STEP, step)
        self._current_step = result.data_value
        return result

    def move_steps(self, value: int) -> IncomingMessage:
        self.logger.info(f"Moving {value} steps")
        result = self._send_packet(ModuleCommand.MOVE_STEPS, value)
        self._current_step = result.data_value
        return result

    def get_steps(self) -> IncomingMessage:
        result = self._send_packet(ModuleCommand.GET_STEPS)
        self._current_step = result.data_value
        return result

    def get_drum_steps(self) -> IncomingMessage:
        result = self._send_packet(ModuleCommand.MOTOR_NUM_STEPS)
        return result

    def set_max_steps(self, value: int) -> IncomingMessage:
        result = self._send_packet(ModuleCommand.SET_MAX_STEPS, value)
        return result

    def get_max_steps(self) -> int:
        return self._get_uint16_from_eeprom(EepromLocations.MAX_STEP_LOCATION.value)

    def move_to_position(self, position: int) -> IncomingMessage:
        # Move to a stored EEPROM position
        if not self.is_valid_position(position):
            raise ValueError(
                f"Position value: {position} must be between 0-{NUM_POSITIONS}"
            )
        result = self._send_packet(ModuleCommand.MOVE_TO_POSITION, value=position)
        self._current_position = position
        self._current_step = result.data_value
        return result

    def set_position(self, position: int) -> IncomingMessage:
        # Update the motors steps in EEPROM position to current location
        if not self.is_valid_position(position):
            raise ValueError(
                f"Position value: {position} must be between 0-{NUM_POSITIONS}"
            )
        # Check if there is already a position at this location
        return self._send_packet(ModuleCommand.SET_POSITION, value=position)

    def get_position(self, position: int) -> IncomingMessage:
        if not self.is_valid_position(position):
            raise ValueError(
                f"Position value: {position} must be between 0-{NUM_POSITIONS}"
            )
        result = self._send_packet(ModuleCommand.GET_POSITION, value=position)
        self._positions_to_steps[position] = result.data_value
        return result

    def get_all_positions(self) -> Dict[int, int]:
        for position in self._positions_to_steps:
            result = self.get_position(position)
        return self._positions_to_steps

    def home(self) -> IncomingMessage:
        self.logger.info("Homing")
        output = self._send_packet(ModuleCommand.HOME)
        self.is_homed = True
        self._current_position = 0
        self._current_step = 0
        return output

    def get_home_offset(self) -> IncomingMessage:
        output = self._send_packet(ModuleCommand.GET_HOME_OFFSET)
        return output

    def set_home_offset(self, value: int) -> IncomingMessage:
        output = self._send_packet(ModuleCommand.SET_HOME_OFFSET, value=value)
        return output

    def get_auto_home(self) -> IncomingMessage:
        output = self._send_packet(ModuleCommand.GET_AUTO_HOME)
        return output

    def set_auto_home(self, on: bool) -> IncomingMessage:
        output = self._send_packet(ModuleCommand.SET_AUTO_HOME, value=int(on))
        return output

    def stop(self) -> IncomingMessage:
        return self._send_packet(ModuleCommand.STOP)

    def set_speed(self, value: int) -> IncomingMessage:
        self.logger.info(f"Setting speed to {value}")
        if not self.is_valid_speed(value):
            raise ValueError(f"Speed value: {value} must be between 0-{MAX_SPEED}")
        return self._send_packet(ModuleCommand.SET_SPEED, value=value)

    def get_speed(self) -> IncomingMessage:
        return self._send_packet(ModuleCommand.GET_SPEED)

    def is_moving(self) -> IncomingMessage:
        return self._send_packet(ModuleCommand.IS_MOVING)

    def get_hall_effect_status(self) -> IncomingMessage:
        return self._send_packet(ModuleCommand.GET_HALL_EFFECT_STATUS)

    def get_eeprom_value(self, location: int) -> IncomingMessage:
        if location < 0 or location > NUM_EEPROM_BYTES - 1:
            raise ValueError(
                f"Unable to get EEPROM location {location} - EPPROM locations are between 0-{NUM_EEPROM_BYTES-1}"
            )
        return self._send_packet(ModuleCommand.GET_EEPROM_VALUE, value=location)

    def set_calibration_mode(self, on: bool) -> IncomingMessage:
        output = self._send_packet(ModuleCommand.SET_CALIBRATION_MODE, value=int(on))
        return output

    def positions_known(self) -> bool:
        return None in list(self._positions_to_steps.values())

    @staticmethod
    def is_valid_position(position_id: int) -> bool:
        return position_id >= 0 and position_id <= NUM_POSITIONS

    @staticmethod
    def is_valid_step(step: int) -> bool:
        return step >= 0 and step <= MOTOR_RESOLUTION

    @staticmethod
    def is_valid_speed(speed: int) -> bool:
        return speed > 0 and speed <= MAX_SPEED

    def _send_packet(
        self, command: ModuleCommand, value: int = 0
    ) -> Optional[IncomingMessage]:
        message = OutgoingMessage(
            row=self.row, column=self.column, command=command, data_value=value
        )
        self._message_count += 1
        self.logger.debug(f"Packet generated for message: {message}")

        if self._command_queue is None:
            raise RuntimeError("No command queue registered")

        future = Future()
        self._command_queue.put((future, message))
        result = future.result()
        if result is None:
            raise ConnectionError(f"No response after sending message: {message}")
        if not result.status:
            self._handle_bad_status(result)

        if future.exception() is not None:
            raise future.exception()
        # This will wait until a response is received
        result = future.result()
        self._lifetime_latency += result.latency_ms
        return result

    def _handle_bad_status(self, response: IncomingMessage) -> None:
        try:
            error_code = ModuleErrorCodes[response.data_value]
            self.logger.warning(f"Response failed with error code {error_code}")
            raise FirmwareException(f"Error Code: {error_code}")
        except KeyError:
            raise FirmwareException(
                f"Unknown error code returned - {response.data_value}"
            )
        except Exception as e:
            self.logger.error(f"Unknown error occured when reading response")
            raise e

    def _get_uint16_from_eeprom(self, start_location: int) -> int:
        value1 = self.get_eeprom_value(start_location)
        value2 = self.get_eeprom_value(start_location + 1)
        return (value2.data_value * 256) + value1.data_value

    @property
    def info(self) -> ModuleInfo:
        return self._info

    @property
    def firmware_version(self) -> str:
        major = self.get_eeprom_value(
            EepromLocations.MAJOR_FIRMWARE_LOCATION
        ).data_value
        minor = self.get_eeprom_value(
            EepromLocations.MINOR_FIRMWARE_LOCATION
        ).data_value
        return f"v{major}.{minor}"

    @property
    def num_positions(self) -> int:
        return NUM_POSITIONS

    @property
    def current_position(self) -> int:
        return self._current_position

    @property
    def location(self) -> Tuple[int, int]:
        return self._location

    @property
    def row(self) -> int:
        return self._location[0]

    @property
    def column(self) -> int:
        return self._location[1]

    @property
    def is_command_queue_registered(self) -> int:
        return self._command_queue is not None

    @property
    def average_latency_ms(self) -> Optional[Union[int, LatencyMs]]:
        if self._message_count <= 0:
            return None
        output = LatencyMs(
            self._lifetime_latency.send / self._message_count,
            self._lifetime_latency.receive / self._message_count,
            self._lifetime_latency.total / self._message_count,
        )
        return self._message_count, output
