itrussell15/SplitFlapDisplay/software/control/source/dataclasses_.py

from __future__ import annotations

import enum
import logging
import struct
from abc import ABC, abstractmethod
from dataclasses import dataclass
from typing import ClassVar


class ModuleCommand(enum.IntEnum):
    PING = 0
    HOME = 1
    STOP = 2
    GET_POSITION = 3
    SET_POSITION = 4  # Stores position in EEPROM
    MOVE_TO_POSITION = 5
    GET_SPEED = 6
    SET_SPEED = 7
    GET_STEPS = 8
    MOVE_TO_STEP = 9
    MOVE_STEPS = 10
    SET_STEP_TARGET = 11
    SET_POSITION_TARGET = 12
    MOVE_TO_TARGET = 13
    GET_HALL_EFFECT_STATUS = 14
    IS_MOVING = 15
    MOTOR_NUM_STEPS = 16
    SET_HOME_OFFSET = 17
    SET_AUTO_HOME = 18
    GET_EEPROM_VALUE = 19
    GET_HOME_OFFSET = 20
    SET_MAX_STEPS = 21
    SET_CALIBRATION_MODE = 22
    BAD_COMMAND = 99


class ModuleErrorCodes(enum.Enum):
    BAD_CHECKSUM = 1
    COMMAND_NOT_FOUND = 2
    INVALID_POSITION_VALUE = 3


@dataclass
class BaseMessage(ABC):
    start_value: int
    row: int
    column: int
    command: ModuleCommand
    end_value: int
    data_value: int = 255
    sequence_id: int = -1
    _struct_string: ClassVar[str] = "<BBBBBHBB"

    def __post_init__(self) -> None:
        self.logger = logging.getLogger(self.__class__.__name__)

    def __int__(self) -> int:
        return int(self.data_value)

    def __bool__(self) -> bool:
        value = int(self.data_value)
        if value != 0 and value != 1:
            raise TypeError(f"Unable to cast value {self.data_value} to bool")
        return bool(value)

    @staticmethod
    def checksum(
        data_value: int, command_value: int, row: int, column: int, sequence_id: int
    ) -> int:
        low_byte = data_value & 0xFF
        high_byte = (data_value >> 8) & 0xFF
        return row ^ column ^ command_value ^ sequence_id ^ low_byte ^ high_byte

    def _create_checksum(self, sequence_id: int) -> int:
        return self.checksum(
            self.data_value, self.command.value, self.row, self.column, sequence_id=sequence_id
        )

    def encode(self, sequence_id: int) -> bytes:
        checksum = self._create_checksum(sequence_id)
        data_packet = [
            self.start_value,
            self.row,
            self.column,
            sequence_id,
            self.command.value,
            self.data_value,
            checksum,
            self.end_value,
        ]
        self.logger.debug(f"Sending Packet: {data_packet}")
        return struct.pack(self._struct_string, *data_packet)

    @classmethod
    def decode(cls, message: bytes) -> BaseMessage:
        try:
            output = struct.unpack(cls._struct_string, message)
            return cls._parse_output(output)
        except Exception as e:
            raise e

    @classmethod
    @abstractmethod
    def _parse_output(cls, data: bytes) -> OutgoingMessage:
        pass

    @property
    def packet_size(cls) -> int:
        return struct.calcsize(cls._struct_string)

    @property
    def location(self) -> Tuple[int, int]:
        return (self.row, self.column)

    @property
    def location_map(self) -> Dict[str, int]:
        return {"row": self.row, "column": self.column}


@dataclass(kw_only=True)
class OutgoingMessage(BaseMessage):
    start_value: int = 2
    end_value: int = 3

    def __post_init__(self) -> None:
        super().__post_init__()
        assert self.start_value == 2
        assert self.end_value == 3

    @classmethod
    def _parse_output(cls, data: bytes) -> OutgoingMessage:
        row = data[1]
        column = data[2]
        sequence_id = data[3]
        command_value = data[4]
        data_value = data[5]
        incoming_checksum = data[6]

        checksum = cls.checksum(
            data_value=data_value,
            command_value=command_value,
            row=row,
            column=column,
            sequence_id=sequence_id
        )
        assert incoming_checksum == checksum, f"Checksum failed - {checksum} != {incoming_checksum}"
        return cls(
            row=row,
            column=column,
            command=ModuleCommand(command_value),
            data_value=data_value,
            sequence_id=sequence_id
        )


@dataclass
class LatencyMs:
    send: float
    receive: float
    total: float

    def __add__(self, item: LatencyMs) -> LatencyMs:
        return LatencyMs(
            send=self.send + item.send,
            receive=self.receive + item.receive,
            total=self.total + item.total
        ) 

    def __mul__(self, value: int) -> LatencyMs:
        return LatencyMs(
            send=self.send * value,
            receive=self.receive * value,
            total=self.total * value
        ) 


@dataclass(kw_only=True)
class IncomingMessage(BaseMessage):
    status: bool
    sequence_id: int
    start_value: int = 4
    end_value: int = 5
    latency_ms: Optional[LatencyMs] = None
    _struct_string: ClassVar[str] = "<BBBBBH?BB"

    def __post_init__(self) -> None:
        super().__post_init__()

    def encode(self) -> bytes:
        checksum = self._create_checksum(self.sequence_id)
        return struct.pack(
            self._struct_string,
            self.start_value,
            self.row,
            self.column,
            self.sequence_id,
            self.command.value,
            self.data_value,
            self.status,
            checksum,
            self.end_value,
        )

    @classmethod
    def _parse_output(cls, data: bytes) -> OutgoingMessage:
        row = data[1]
        column = data[2]
        sequence_id = data[3]
        command_value = data[4]
        data_value = data[5]
        status = data[6]
        checksum = data[7]

        calculated_checksum = cls.checksum(
            data_value, command_value, row, column, status, sequence_id
        )
        if checksum != calculated_checksum:
            raise ValueError(
                f"Received Checksum doesn't match calculated value. {checksum} != {calculated_checksum}"
            )
        return cls(
            row=row,
            column=column,
            sequence_id=sequence_id,
            command=ModuleCommand(command_value),
            data_value=data_value,
            status=status,
        )

    def _create_checksum(self, sequence_id: int) -> int:
        return self.checksum(
            self.data_value, self.command.value, self.row, self.column, status=self.status, sequence_id=sequence_id
        )

    @staticmethod
    def checksum(
        data_value: int,
        command_value: int,
        row: int,
        column: int,
        status: bool,
        sequence_id: int,
    ) -> int:
        low_byte = data_value & 0xFF
        high_byte = (data_value >> 8) & 0xFF
        return (
            row ^ column ^ command_value ^ low_byte ^ high_byte ^ status ^ sequence_id
        )
