itrussell15/SplitFlapDisplay/software/control/source/serial_processor.py

import logging
import threading
import time
from abc import ABC, abstractmethod
from concurrent.futures import Future
from collections import deque
from queue import Queue
from typing import List, Optional, Union
from concurrent.futures import Future

import serial

from .dataclasses_ import BaseMessage, LatencyMs


class SerialControl:
    def __init__(self, port: str, baudrate: int = 19200, timeout: int = 1):
        self.logger = logging.getLogger(f"{self.__class__.__name__}({port})")
        self.port = port
        self.baudrate = baudrate
        self._timeout = timeout
        self.timeout = timeout
        self.connection = None
        self.bad_packets = []

    @property
    def timeout(self) -> float:
        return self._timeout

    @timeout.setter
    def timeout(self, value: float) -> None:
        if value < 0:
            raise ValueError("Value must be non-negative")
        self._timeout = value

    def connect(self):
        """Attempts to open the serial port."""
        try:
            self.connection = serial.Serial(
                port=self.port, baudrate=self.baudrate, timeout=self.timeout
            )
            self.logger.debug(f"✅ Connected to {self.port}")
        except serial.SerialException as e:
            self.logger.debug(f"❌ Error connecting to {self.port}: {e}")

    def send(self, message: bytes):
        """Encodes and sends a string to the bus."""
        if self.connection and self.connection.is_open:
            # Adding a newline is common practice for serial commands
            self.connection.write(message)
            self.logger.debug(f"TX -> {message}")
        else:
            self.logger.debug("⚠️ Not connected. Cannot send.")

    def read(self, size: int = 1) -> Optional[bytes]:
        """Reads a line from the bus and decodes it."""
        if self.connection and self.connection.is_open:
            line = self.connection.read(size)
            if line:
                self.logger.debug(f"RX <- {line}")
                return line
        return None

    def read_packet(
        self, start_value: bytes, end_value: bytes, size: int
    ) -> Optional[bytes]:
        buffer = bytes()
        data = end_value
        start_time = time.time()
        timed_out = False
        while not timed_out:
            if self.connection.in_waiting >= size:
                data = self.connection.read()
                if data == start_value:
                    break
            time_delta = time.time() - start_time
            timed_out = time_delta > self.timeout

        if timed_out:
            raise TimeoutError(
                f"Device on {self.port} failed to respond within {self.timeout}s"
            )

        buffer += data
        for _ in range(size - 2):
            byte_read = self.connection.read()
            buffer += byte_read

        data = self.connection.read()
        if data != end_value:
            self.logger.warning(f"Malformed Packet: {buffer} + {data}")
            self.bad_packets.append(buffer + data)
            return buffer + data
        else:
            buffer += data

        self.logger.debug(f"Packet received: {buffer}")
        return buffer

    def close(self):
        """Closes the connection cleanly."""
        if self.connection:
            self.connection.close()
            self.logger.debug("🔌 Connection closed.")

    @property
    def is_data_waiting(self) -> bool:
        if not self.connection:
            raise ConnectionError(f"{self.port} not connected")
        return self.connection.in_waiting > 0
    
    @property
    def data_waiting_size(self) -> int:
        if not self.is_data_waiting:
            return 0
        return self.connection.in_waiting


class SerialProcessor(ABC, SerialControl):

    def __init__(
        self,
        port: str,
        baudrate: int = 9600,
        timeout: int = 1,
        num_retries: int = 3,
        max_queue_size: int = 64,
        latency_window_size: int = 100
    ) -> None:
        SerialControl.__init__(self, port, baudrate, timeout)
        self.queue = Queue(maxsize=max_queue_size)
        self.num_retries = num_retries
        self._stop_event = threading.Event()
        self._lifetime_latency_total = LatencyMs(0, 0, 0)
        self._lifetime_latency_count = 0
        self._latency_window = deque(maxlen=latency_window_size)

    def worker(self):
        sequence_id: int = 0
        self.logger.debug("Processor started")
        while not self._stop_event.is_set():
            self.advance_queue(sequence_id)
            sequence_id = (sequence_id + 1) % 256

    def advance_queue(self, sequence_id: int) -> None:
        if self.connection and self.connection.is_open:
            self.connection.reset_input_buffer()
        future, item = self.queue.get()
        try:
            self.process_message(sequence_id, item, future)
        finally:
            self.queue.task_done()

    def process_message(self, sequence_id: int, item: BaseMessage, future: Future) -> None:
        start_time = time.time()
        attempt = 0
        while True:
            try:
                self._send_serial_command(item.encode(sequence_id))
                send_time = time.time()
                response = self._read_serial_response()
                read_time = time.time()
                self.logger.debug(f"Response: {response}")
                result = self._handle_response(response, item, sequence_id)
                result.latency_ms = self._get_latency(start_time, send_time, read_time)
                future.set_result(result)
                return
            except Exception as e:
                attempt += 1
                if attempt <= self.num_retries:
                    self.logger.debug(f"Attempt {attempt} failed - retrying")
                    continue
                future.set_exception(e)
                self.logger.error(str(e))
                return

    def start_processor(self) -> threading.Thread:
        self.logger.debug("Starting processor thread")
        processor = threading.Thread(target=self.worker, daemon=True)
        processor.start()
        return processor

    def _send_serial_command(self, command: bytes) -> bool:
        self.logger.debug(f"Raw packet being sent {command}")
        self.send(command)

    @abstractmethod
    def _read_serial_response(self) -> BaseMessage:
        pass

    @abstractmethod
    def _handle_response(
        self, incoming: BaseMessage, outgoing: BaseMessage, sequence_id: int
    ) -> BaseMessage:
        pass

    def _get_latency(
        self, start_time: float, send_time: float, read_time: float
    ) -> LatencyMs:
        send = (send_time - start_time) * 1e3
        receive = (read_time - send_time) * 1e3
        output = LatencyMs(send=send, receive=receive, total=send + receive)
        self._latency_window.append(output)
        self._lifetime_latency_total += output
        self._lifetime_latency_count += 1
        return output

    def close(self) -> None:
        if not self.queue.empty():
            self.logger.info(
                f"Waiting for {self.queue.qsize()} commands to complete before closing"
            )
        while not self.queue.empty():
            time.sleep(0.1)
        self._stop_event.set()
        self.logger.info("Closing serial connection")
        super().close()

    @property
    def is_alive(self) -> bool:
        return not self._stop_event.is_set()

    @property
    def latency_window(self) -> List[LatencyMs]:
        return list(self._latency_window)
    
    @property 
    def average_latency(self) -> Union[int, LatencyMs]:
        return (
            self._lifetime_latency_count,
            LatencyMs(
                self._lifetime_latency_total.send / self._lifetime_latency_count,
                self._lifetime_latency_total.receive / self._lifetime_latency_count,
                self._lifetime_latency_total.total / self._lifetime_latency_count,
            )
        )
