itrussell15/SplitFlapDisplay/software/control/test/test_display_controller.py

import os
import logging
import struct
import sys
import threading
import time
import unittest
from pathlib import Path
from concurrent.futures import Future

# Add the parent directory to the path
sys.path.insert(0, str(Path(__file__).parent.parent.parent))

from source.bus_controller import BusController
from source.flaps import Flap
from source.display_controller import DisplayController
from source.dataclasses_ import IncomingMessage, ModuleCommand, OutgoingMessage
from source.module_controller import MAX_SPEED, ModuleController, MOTOR_RESOLUTION, FirmwareException
from utils import create_logger, get_all_env_vars, Range

SLEEP_TIME_S = 1.0

env_vars = get_all_env_vars()
NUM_ROWS = int(env_vars["DISP_MAX_ROWS"])
NUM_COLS = int(env_vars["DISP_MAX_COLUMNS"])


class TestDisplayController(unittest.TestCase):

    @classmethod
    def setUpClass(cls):
        create_logger(level=logging.DEBUG, spacing=23)

        port = os.getenv("DISP_USB_PORT")
        cls.bus = BusController(port=port, timeout=0.75)
        cls.bus.discover(Range(1, NUM_ROWS), Range(1, NUM_COLS), 0.1)
        cls.display = DisplayController()
        cls.display.add_bus_controller(cls.bus)

    @classmethod
    def tearDownClass(cls):
        # Runs once after ALL tests in this class
        time.sleep(0.5)
        cls.bus.close()

    def setUp(self):
        self.timeout = 0.5
        self.display.reset_processed_commands()
    
    def tearDown(self):
        time.sleep(0.5)
        self.timeout = 0.5

    def test_discover(self) -> None:
        self.display.discover(NUM_ROWS + 1, NUM_COLS + 1)
        self.assertEqual(self.display.num_buses, 1)
        self.assertEqual(self.display.num_modules, 1)
        self.assertEqual(self.display.processed_commands, 1)

    def test_move_all_position(self) -> None:
        self.display.move_all_to_position(0)

    def test_move_to_position(self) -> None:
        self.display.move_to_position(
            {
                (1, 1): 25
            }
        )

    def test_move_to_flaps(self) -> None:
        self.display.move_to_flaps(
            {
                (1, 1): Flap.B,
                (1, 2): Flap.O,
                (1, 3): Flap.O,
                (1, 4): Flap.B,
                (1, 5): Flap.S
            }
        )
        time.sleep(10)
        self.display.move_to_flaps(
            {
                (1, 1): Flap.C,
                (1, 2): Flap.A,
                (1, 3): Flap.R,
                (1, 4): Flap.L,
                (1, 5): Flap.Y
            }
        )
        time.sleep(10)
        self.display.move_to_flaps(
            {
                (1, 1): Flap.I,
                (1, 2): Flap.HEART,
                (1, 3): Flap.Y,
                (1, 4): Flap.O,
                (1, 5): Flap.U
            }
        )

    def test_get_all_steps(self) -> None:
        out = self.display.get_all_steps()
        print(out)

    def test_move_all_to_step(self) -> None:
        out = self.display.move_all_to_step(2850)
        print(out)

    def test_move_to_step(self) -> None:
        value = 2800
        steps = {
            (1, 1): value,
            (1, 2): value - 100,
        }
        out = self.display.move_to_steps(steps)
        print(out)

    def test_set_all_position(self) -> None:
        out = self.display.set_all_position_steps(0)
        print(out)

    def test_home_all(self) -> None:
        out = self.display.home_all()
        print(out)

    def test_get_current_positions(self) -> None:
        out = self.display.get_current_positions()
        print(out)
        self.display.move_to_position(
            {location: 15 for location in self.modules}
        )
        out = self.display.get_current_positions()
        print(out)
