itrussell15/SplitFlapDisplay/(commit log)

2026-05-09 rebase on current main
2026-05-11 Start testing serial comms on arduino board
2026-05-12 Fix data value reading on firmware side
    [drive_firmware.ino, module_controller.py, test_bus_controller.py]
2026-05-14 Add error handling for 'handleIncomingMessage'
    [bus_controller.py, dataclasses_.py, drive_firmware.ino]
2026-05-14 Change module_id to rows and columns to be able to locate the module when it is on the board
2026-05-16 Complete stepper motor code
2026-05-18 Update with motor hardware.
2026-05-20 Fix serial processor bug
    [serial_processor.py]
2026-05-26 bug fixes for discovery. Front end development
    [context.py, drive_firmware.ino, main.py, test_bus_controller.py]
2026-05-27 Working custom board firmware
2026-05-27 Firmware updates to move the motor async and enable broadcast commands
2026-06-01 AI suggestions for fixing discover/ping
    [bus_controller.py, test_bus_controller.py]
2026-06-01 Add smaller flap stls
    [flaps1.stl, flaps2.stl, flaps3.stl]
2026-06-02 Create smaller build version
    [flaps_4plate.scad]
2026-06-02 Add letters
    [flaps_4plate.scad]
2026-06-02 Update generator to have custom rows and columns. Include doc about possible unicode chars
    [flaps_custom.scad]
2026-06-02 Make variable generator with multiple different fonts to support emojis and symbols.
    [flaps1.stl, flaps2.stl, flaps3.stl, flaps_custom.scad, plate1_inlay.stl, plate2_inlay.stl, plate3_inlay.stl]
2026-06-02 Update spacing for symbols and special chars
    [flaps_custom.scad, plate3_inlay.stl]
2026-06-02 Add offset for front and back flap creation
    [flaps_custom.scad]
2026-06-03 Add plate stls
    [flaps_custom.scad, plate1_inlay.stl, plate2_inlay.stl]
2026-06-04 Update with 3mf flap files and start to debug multi module comms
    [Flaps_holding_case.stl, plate1.3mf, plate2.3mf]
2026-06-04 AI serial fixes. Remove the timeout in `Future` to fix double timeouts
    [bus_controller.py, module_controller.py]
2026-06-08 Add camera stream to frontend
2026-06-09 Start trying to calibration
2026-06-10 Continue integration and calibration
2026-06-11 Debug firmware and calibration
2026-06-12 Investigate calibration issues
2026-06-14 Calibration issues
2026-06-16 Calibration work. May need to refine speeds for better accuracy
2026-06-16 Fix ability to have holding torque indefinitely. Add a slower step count for smaller moves to get more torque.
    [Stepper.cpp, Stepper.h, drive_firmware.ino]
2026-06-16 Small firmware and calibration edits
2026-06-17 Progress on calibration with random word displayer
2026-06-18 Firmware fixes for re-zeroing
    [Stepper.h, drive_firmware.ino]
2026-06-30 Add calibration page
2026-07-03 Print setting changes. Start exporting individual flaps
    [flap1-in.stl, flap1.3mf, flap1.stl, flap2-in.stl, flap2.stl, flap3-in.stl, flap3.stl, flap4-in.stl]
2026-07-10 Add updater testing
    [module_case.3mf]
2026-07-15 Add updated CAD changes
    [DIN Rail Mount.3mf, Din Bracket EasierV2.stl, Gear Plate.3mf, Gear_Plate.3mf, Module Enclosure - Enclosure.3mf, din_rail_mount.stl]
2026-07-16 Add DIN spacer
    [DIN Spacer with Screw Hole.stl]
2026-07-18 Add small flaps plates
    [small_plate1.3mf, small_plate2.3mf, small_plate3.3mf]
2026-07-22 Add top cover with features to help guide through bolts
    [Module Enclosure - Enclosure Cover Top.3mf, top_cover.3mf]
2026-07-28 Add drum CAD files based on printing success
    [Character Drum - Character Drum Lip.3mf, Character Drum - Character Drum Main.3mf, Character Drum.3mf, Drum_Lip.3mf, Drum_Main.3mf, small_plate2.3mf]
2026-08-06 Add at symbol flap
    [at_symbol.3mf]
2026-08-07 Add mega plate
    [mega_plate.3mf]
2026-08-07 Add mini plate
    [mini_plate.3mf]
2026-08-17 Add all individual flaps
    [A.3mf, AT.3mf, C.3mf, DASH.3mf, DOLLAR.3mf, DOWN.3mf, E.3mf, EIGHT.3mf]
2026-09-01 Update flap names to be indexable. Update E to be the correct flap
    [1-A.3mf, 10-S.3mf, 11-U.3mf, 12-W.3mf, 13-Y.3mf, 14-ZERO.3mf, 15-TWO.3mf, 16-FOUR.3mf]
2026-11-04 Non block calibration process with multiple modules
2026-11-04 Add ok to all during calibration flow
2026-11-10 Add App landing page image
